palm-detective/oscilloscope-/README.md

# oscilloscope-
upgrade of Ds211 hardware and software all open source

update processor to stm32f4 processor
change display to 3.5 inch raspberry pi diplay using spi
change switches to touch screen
change ide from iar to stm cube
board to fit in raspberry pi 3B case
