palm-detective/oscilloscope-/easyeda/BOM_oscilliscope copy_2023-02-05.csv

ID | Name | Designator | Footprint | Quantity | Manufacturer Part | Manufacturer | Supplier | Supplier Part | Price
1 | 33uF | C1,C2 | CAP-SMD_L3.2-W1.6-RD | 2 | TC211A336M006Y | Sunlord | LCSC | C128344 | 0.02
2 | 1uF | C3,C16,C19,C22 | C0402 | 4 | CL05A105KP5NNNC | SAMSUNG | LCSC | C14445
3 | 4.7uF | C4,C5,C8,C10 | C0805 | 4 | CL21A475KAQNNNE | SAMSUNG | LCSC | C1779 | 0.002
4 | 7pF | C6,C7,C9 | C0402 | 3 | 0402CG7R0C500NT | FH | LCSC | C1577
5 | 33pF | C11,C24 | C0402 | 2 | 0402CG330J500NT | FH | LCSC | C1562
6 | 100nF | C12,C13,C14,C15,C17,C27,C28,C29 | C0402_NEW | 8 | CL05B104KO5NNNC | SAMSUNG | LCSC | C1525
7 | 10uF | C18,C20,C23 | C0402 | 3 | CL05A106MQ5NUNC | SAMSUNG | LCSC | C15525 | 0.001
8 | 10pF | C21 | C0603 | 1 | CL10C100JB8NNNC | SAMSUNG | LCSC | C1634 | 0.001
9 | 47pF | C25 | C0603 | 1 | CL10C470JB8NNNC | SAMSUNG | LCSC | C1671 | 0.001
10 | 510pF | C26 | C0603 | 1 | CL10B511KB8NNNC | SAMSUNG | LCSC | C170144 | 0.002
11 | SMBJ5.0CA | D1 | SMB_L4.6-W3.6-LS5.3-BI | 1 | SMBJ5.0CA | Brightking | LCSC | C78424 | 0.009
12 | LESD5Z5.0T1G | D2,D3,D4,D5 | SOD-523_L1.2-W0.8-LS1.6-RD | 4 | LESD5Z5.0T1G | LRC | LCSC | C136171 | 0.003
13 | Header-1x2 | H1 | HDR-TH_2P-P2.54-V-M-1 | 1 | 826629-2 | TE Connectivity | LCSC | C86471 | 0.067
14 | MTP125-1213S1 | H2 | HDR-TH_26P-P2.54-V-M-R2-C13-S2.54 | 1 | MTP125-1213S1 | MINTRON | LCSC | C358701 | 0.023
15 | 10Ω | L1,L2,L3,L4,L5,L6 | L0402 | 6 | BLM15AG100SN1D | MuRata | LCSC | C76882 | 0.001
16 | 100uH | L7,L8 | IND-SMD_L3.5-W3.0 | 2 | SCCD32-101KT | Yanchuang | LCSC | C532859 | 0.005
17 | 2kΩ | R4 | R0402 | 1 | 0402WGF2001TCE | UniOhm | LCSC | C4109
18 | 1M | R6 | R0603 | 1 | 0603WAF1004T5E | UniOhm | LCSC | C22935
19 | 1kΩ | R7,R8 | R0402 | 2 | 0402WGF1001TCE | UniOhm | LCSC | C11702
20 | 22 | R9,R15 | R0402 | 2 | RC0402FR-0722RL | YAGEO | LCSC | C114765
21 | 18kΩ | R10,R16 | R0402 | 2 | 0402WGF1802TCE | UniOhm | LCSC | C25762
22 | 75kΩ | R11,R12 | R0402 | 2 | 0402WGF7502TCE | UniOhm | LCSC | C25798
23 | 1.5M | R13 | R0603 | 1 | 0603WAF1504T5E | UniOhm | LCSC | C4172
24 | 330K | R14 | R0603 | 1 | RTT03334JTP | RALEC | LCSC | C103555
25 | DOSIN-801-0005 | RF1 | BNC-TH_DOSIN-801-0005 | 1 | DOSIN-801-0005 | dosinconn | LCSC | C521213 | 0.286
26 | 3.3kΩ | RN1 | RES-ARRAY-SMD_0603-8P-L3.2-W1.6-BL | 1 | 4D03WGJ0332T5E | UNI-ROYAL(厚声) | LCSC | C12013 | 0.001
27 | 74HC4053PW | U1 | TSSOP-16_L5.0-W4.4-P0.65-LS6.4-BL | 1 | 74HC4053PW | PHILIPS | LCSC | C5648 | 0.046
28 | TSH82IDT | U2 | SO-8_L4.9-W3.9-P1.27-LS5.9-BL | 1 | TSH82IDT | STMicroelectronics | LCSC | C221510 | 0.194
29 | MAX1720EUTG | U3 | TSOP-6_L3.0-W1.5-P0.95-LS2.8-BR | 1 | MAX1720EUTG | ON Semicon | LCSC | C70466 | 0.076
30 | STM32F446RCT6 | U4 | LQFP-64_L10.0-W10.0-P0.50-LS12.0-BL | 1 | STM32F446RET6 | STMicroelectronics | LCSC | C69336 | 1.037
31 | AMS1117-3.3 | U5 | SOT-223_L6.5-W3.5-P2.30-LS7.0-BR | 1 | AMS1117-3.3 | SK | LCSC | C165482 | 0.012
32 | W25Q64JVSSIQ | U6 | SOP-8_L5.3-W5.3-P1.27-LS8.0-BL | 1 | W25Q64JVSSIQ | WINBOND | LCSC | C83140 | 0.071
33 | MICRO-02 | USB1 | MICRO-USB-SMD_MICRO-02-GXPX-A1T2 | 1 | MICRO-02-G1P3-A1T2 | Yuandi(台湾元迪) | LCSC | C2682518 | 0.011
34 | 25MHz | X1 | OSC-SMD_4P-L3.2-W2.5-BL | 1 | X322525MOB4SI | YXC | LCSC | C9006 | 0.014
