palm-detective/oscilloscope-/todo.txt

08/22/2021  add touch buttons DONE
            fix routing on pcb DONE
            use 0402 components rather than 0603 DONE

09/11/2021  finish simulation
            software test

future	    use rspberry pi 4 format -- usb c
	    add pulseview interface
            add sd card
