palm-detective/oscilloscope-/easyeda/Schematic_oscilliscope copy_2022-06-30.pdf

# S2 10 S1 11 1Y0 12 1Y1 13 1Z 14 2Z 15 VCC 16

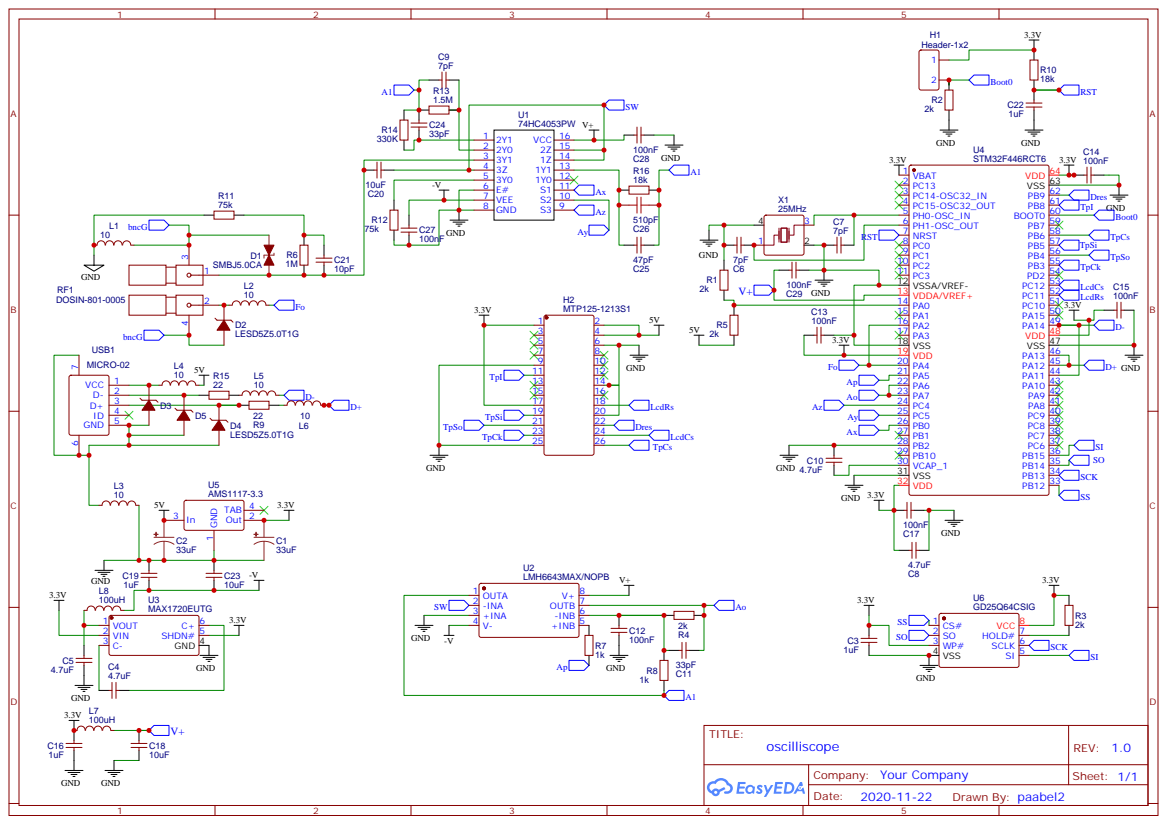
[picture p10: page 1]
