palm-detective/oscilloscope-/ltspicemodel/Schematic_Simulation_2021-08-07.pdf

# S2 10 S1 11 1Y0 12 1Y1 13 1Z 14 2Z 15 VCC 16

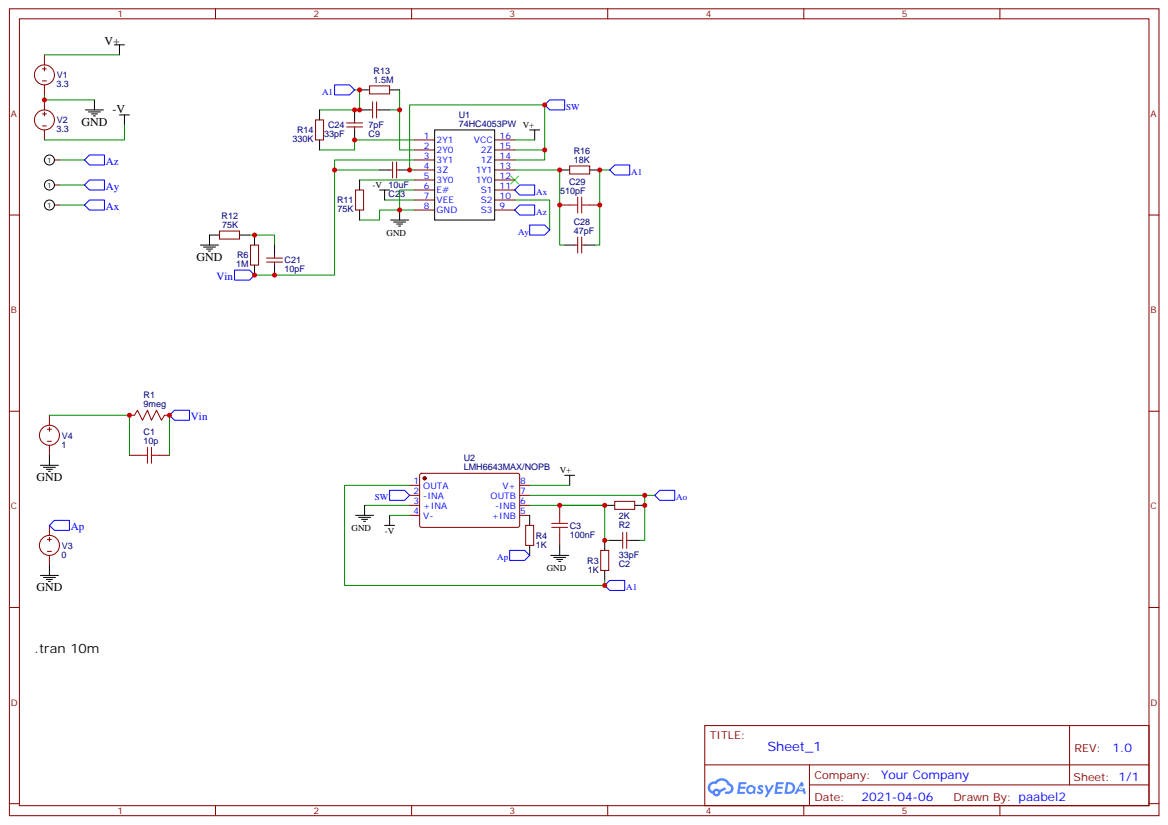
[picture p12: page 1]
