palm-detective/oscilloscope-/easyeda/Schematic_oscilliscope copy_2021-07-18.pdf

# S2 10 S1 11 1Y0 12 1Y1 13 1Z 14 2Z 15 VCC 16

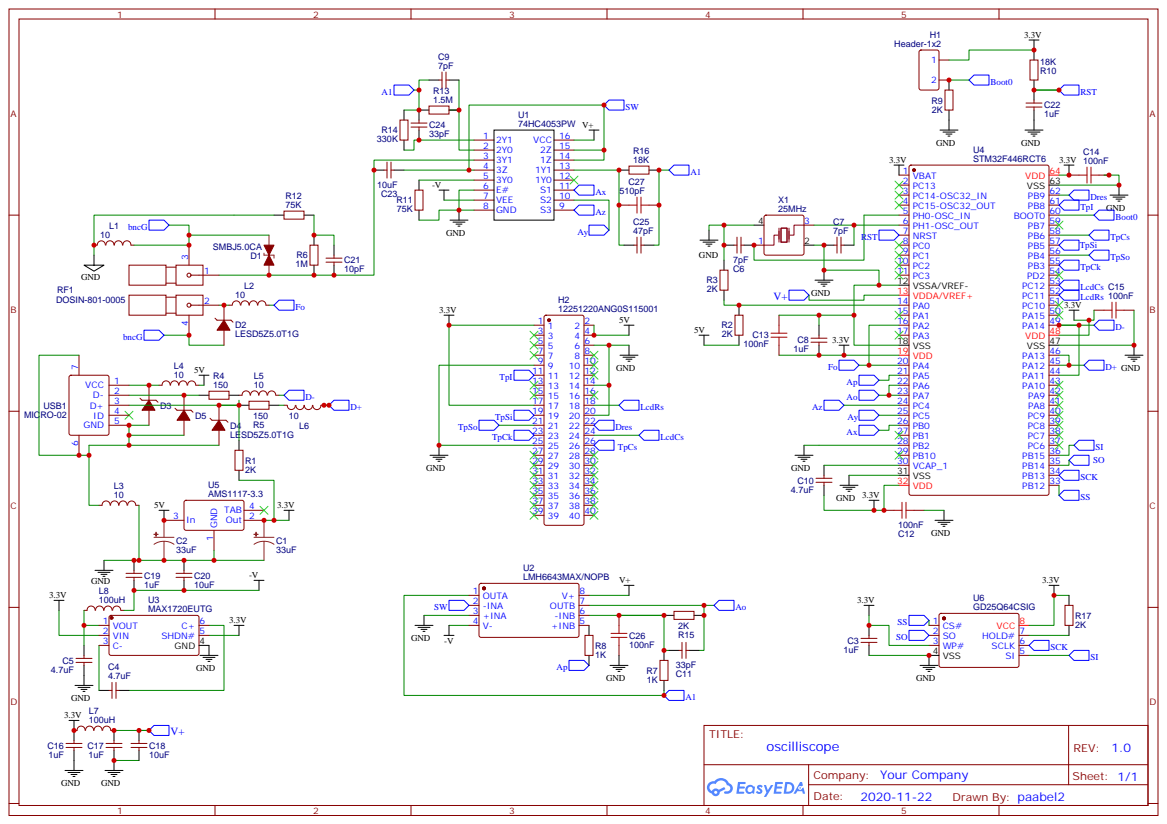
[picture p13: page 1]
