palm-detective/oscilloscope-/easyeda/PCB_NEW_PCB_2023-02-05.pdf

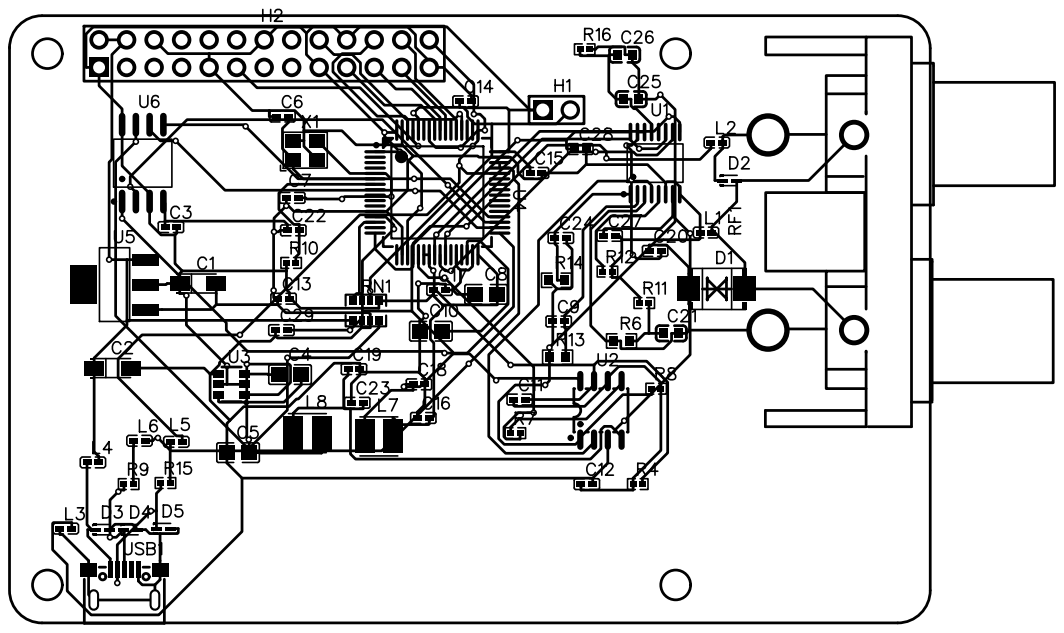
[picture p14: page 1]
