palm-detective/oscilloscope-/ltspicemodel/sim1224.pdf

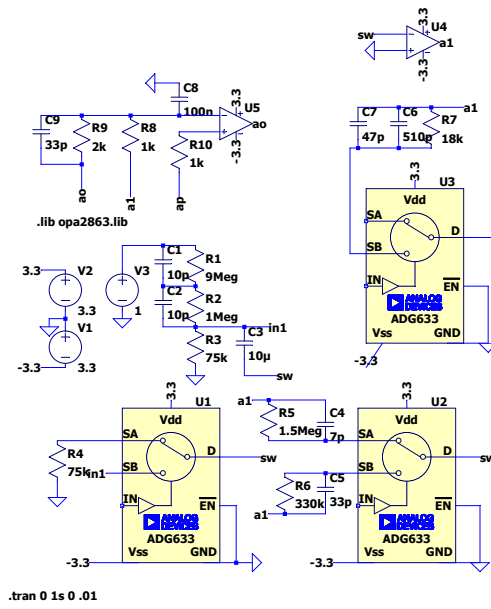
[picture p15: page 1]
