palm-detective/oscilloscope-/ltspicemodel/sin1221.pdf

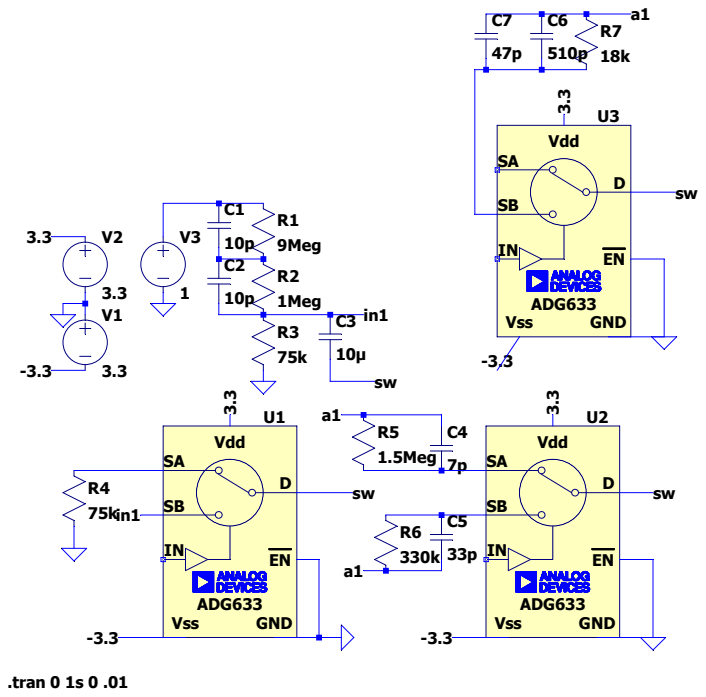
[picture p16: page 1]
