palm-detective/oscilloscope-/easyeda/PCB_NEW_PCB_2022-08-28.pdf

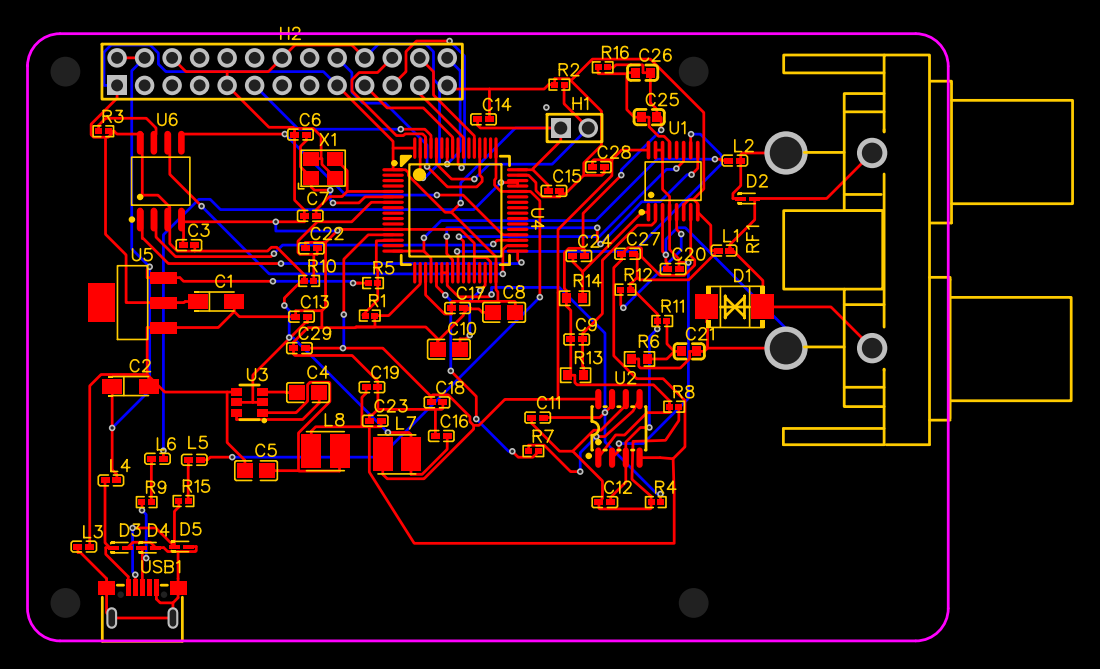
[picture p17: page 1]
