palm-detective/oscilloscope-/easyeda/PCB_NEW_PCB_2022-07-08.pdf

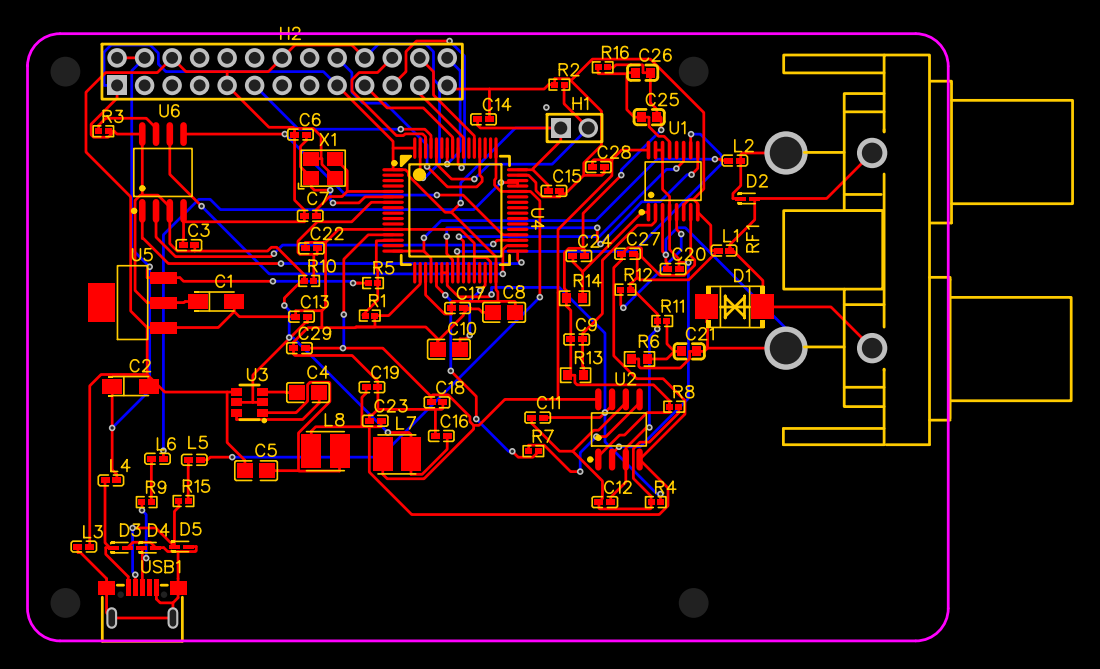
[picture p18: page 1]
