palm-detective/oscilloscope-/easyeda/PCB_NEW_PCB_2022-07-03.pdf

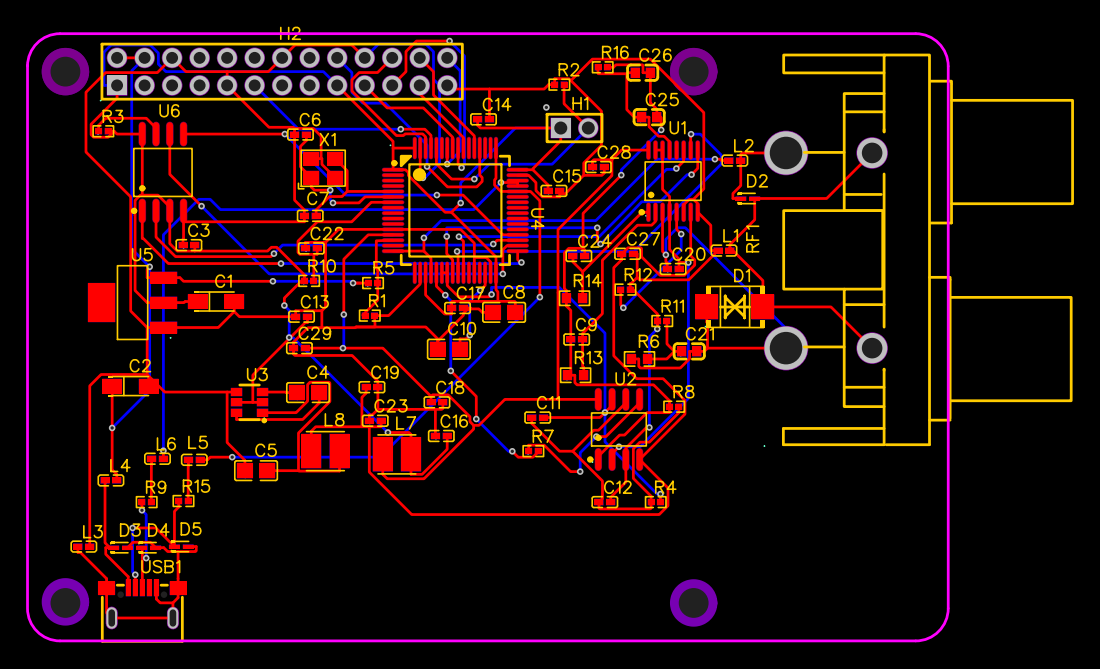
[picture p19: page 1]
