palm-detective/oscilloscope-/ltspicemodel/sim.asc

C1: cap; 10p
C2: cap; 10p
C3: cap; 10µ
C4: cap; 7p
C5: cap; 33p
C6: cap; 510p
C7: cap; 47p
C8: cap; 100n
C9: cap; 33p
R1: res; 9Meg
R2: res; 1Meg
R3: res; 75k
R4: res; 75k
R5: res; 1.5Meg
R6: res; 330k
R7: res; 18k
R8: res; 1k
R9: res; 2k
R10: res; 1k
U1: ADG633
U2: ADG633
U3: ADG633
U4: OPA2683
U5: OPA2683
V1: voltage; 3.3
V2: voltage; 3.3
V3: voltage; SINE(0 1 1k)
Named nets: 0, 3.3, -3.3, in1, sw, a1, ao, ap
.lib opa2863.lib
.tran 0 0.1s 0 0.001
