palm-detective/oscilloscope-/(list of files, drawings)

Other design files:
easyeda/Autorouter_NEW_PCB_2021-09-06.dsn
easyeda/PCB_NEW_PCB_2021-08-04.json
easyeda/PCB_NEW_PCB_2021-09-06.json
easyeda/PCB_NEW_PCB_2021-09-11.json
easyeda/SCH_oscilliscope copy_2021-08-04.json
easyeda/SCH_oscilliscope copy_2021-09-11.json
