palm-detective/oscilloscope-/oscilliscope/Core/Src/main.c

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
/* Includes ------------------------------------------------------------------*/
#include "main.h"
#include "fatfs.h"
#include "usb_device.h"

/* USER CODE BEGIN Includes */
#include "Lcd_ctl.h"
#include "Touch_ctl.h"
#include "Flash.h"
#include "Draw.h"
#include "Process.h"
#include "File.h"
#include "Menu.h"
#include "Display.h"
#include "Bios.h"
#include "Flash.h"
/* USER CODE END Includes */

ADC_HandleTypeDef hadc1;
ADC_HandleTypeDef hadc2;
DMA_HandleTypeDef hdma_adc1;

DAC_HandleTypeDef hdac;
DMA_HandleTypeDef hdma_dac1;

SPI_HandleTypeDef hspi2;
SPI_HandleTypeDef hspi3;

TIM_HandleTypeDef htim1;
TIM_HandleTypeDef htim3;
TIM_HandleTypeDef htim5;
TIM_HandleTypeDef htim7;

/* USER CODE BEGIN PV */
TIM_OC_InitTypeDef octim1;
TIM_OC_InitTypeDef octim3;
TIM_OC_InitTypeDef octim5;
char  APP_VERSION[] = "V2.00";   //bump version to 2
/* USER CODE END PV */

void SystemClock_Config(void);
static void MX_GPIO_Init(void);
static void MX_DMA_Init(void);
static void MX_ADC1_Init(void);
static void MX_ADC2_Init(void);
static void MX_DAC_Init(void);
static void MX_SPI2_Init(void);
static void MX_SPI3_Init(void);
static void MX_TIM1_Init(void);
static void MX_TIM3_Init(void);
static void MX_TIM5_Init(void);
static void MX_TIM7_Init(void);
/**
  * @brief  The application entry point.
  * @retval int
  */
int main(void)
{
  /* USER CODE BEGIN 1 */
  short i;
  char SAVE_FLAG = 0;
  char Pop_Num = 0;
  unsigned dma_tmp;
  /* USER CODE END 1 */

  /* MCU Configuration--------------------------------------------------------*/

  /* Reset of all peripherals, Initializes the Flash interface and the Systick. */
  HAL_Init();

  /* Configure the system clock */
  SystemClock_Config();

  /* Initialize all configured peripherals */
  MX_GPIO_Init();
  MX_DMA_Init();
  MX_ADC1_Init();
  MX_ADC2_Init();
  MX_DAC_Init();
  MX_SPI2_Init();
  MX_SPI3_Init();
  MX_TIM1_Init();
  MX_TIM3_Init();
  MX_TIM5_Init();
  MX_USB_DEVICE_Init();
  MX_TIM7_Init();
  MX_FATFS_Init();
  /* USER CODE BEGIN 2 */

  // initialize adc dma
  __HAL_DMA_DISABLE(&hdma_adc1);
  dma_tmp = hdma_adc1.Instance->CR;
  dma_tmp &= 0x0FFCFFFE;
  dma_tmp |= 0x30000; //set very high pirority
  hdma_adc1.Instance->CR = dma_tmp;

   hdma_adc1.Instance->M0AR = (unsigned)&Sampl[2];
   hdma_adc1.Instance->PAR = hadc1.Instance->DR;
   __HAL_DMA_SET_COUNTER(&hdma_adc1, 0x1000);
   __HAL_DMA_ENABLE(&hdma_adc1);

  // inittialize LCD and touch screen
  Init_LCD();
  Init_Touch();

  SetColor(BLK, WHT);

  DispStr8x14(8, 90, PRN, "         Oscilloscope              ");
  DispStr8x14(8+22*8, 90, PRN, APP_VERSION);
  DispStr8x14(8, 70, PRN, "        System Initializing...       ");

  HAL_Delay(1000);

//=============================check callibration׼===========================
  Read_CalFlag();

  if(Cal_Flag == 1)
  {
	  Cal_Flag = 0;
	  SetColor(BLK, WHT);
	  Zero_Align();                              //set zero
	  Restore();                                 //restore list
	  Save_Parameter();                          //save list
	  Save_Kpg();
  }
  Read_Kpg();
  Read_Parameter();
  File_Num();
  memcpy(Data, DEMO, 310);

  LCD_ClrScrn(GRY);
  Update_Title();

  List[SMPL_DPTH].Flg |= UPD;

  StdBy_Time = List[STANDBY].Val * MIN_UNIT;

  // Start timer
  HAL_TIM_Base_Start_IT(&htim3);

  /* USER CODE END 2 */

  /* Infinite loop */
  /* USER CODE BEGIN WHILE */
  while (1)
  {
	    if((List[STANDBY].Val != 0)&&(StdBy_Time == 0))
	    {
	      StdBy_Flag = 1;
	    }

	    Update_Detail();
	    Update_Blink();
	    WaveProcess();
	    DrawWindow(WaveBuf, ParamTab);

	   if(TIM_BASE_Val!=0)
	    {
	      List[TIM_BASE].Val=TIM_BASE_Val;
	      List[TIM_BASE].Flg |= UPD;
	      TIM_BASE_Val=Current;
	      Update_Title();
	      Current=TIM_BASE_Val;
	      TIM_BASE_Val=0;
	    }
    /* USER CODE END WHILE */

    /* USER CODE BEGIN 3 */
	    if(Key_Buffer != 0)
	    {
	      StdBy_Flag = 0;
	      PopupCnt = 10;
	      List[MenuNow[Current]].Flg |= UPD;

	      switch (Key_Buffer)
	      {
	     case KEYCODE_MEM:
	         i = Save_Bmp(List[SAVE_BMP].Val);
	         DispFileInfo(i);
	         DispBMPInfo();
	        break;

	     case KEYCODE_ACT:
	       SAVE_FLAG=0;
	       if(PopType & DAILOG_POP) Close_Pop();
	       else {
	         Dialog_Pop("Save All ParamTab?");
	         Pop_Num = 1;
	       }
	       break;

	     case KEYCODE_PLAY:
	       if((Current == ST)&&(Cal_Flag==0))
	       {
	         if(PopType & DAILOG_POP){
	           if(Pop_Num == 1){
	             Save_Parameter();
	             Close_Pop();
	           }
	           else{
	             Close_Pop();
	             List_Pop();
	           }
	         }
	         else if((PopType & LIST_POP) && (MenuNow[ST]==RESTORE )) {
	           Restore_CalPar();
	           Dialog_Pop("Save All ParamTab?");
	           Cal_Flag = 1;
	         }
	         else if((PopType & LIST_POP) && (MenuNow[ST]==AUTO_CAL )) {
	           Close_Pop();
	           Calibrate_Pop("Waiting for Calibration...");
	           Cal_Flag = 1;
	           DrawWindow(WaveBuf, ParamTab);
	           Zero_Align();
	           Update_Proc_All();
	           Close_Pop();
	           CalSave_Pop("Save Cal ParamTab?");
	         }
	         break;
	       }
	       else if((Current == ST)&&(Cal_Flag==1)){
	         if(PopType & DAILOG_POP){
	           Save_Kpg();
	           Close_Pop();
	           Cal_Flag = 0;
	         }
	         break;
	       }

	       if ((Current == FN)&&(PopType & LIST_POP)){
	         i = 0;
	         {
	           if(SAVE_FLAG==KEYCODE_MEM)Close_Pop();
	           if(MenuNow[FN] == SAVE_BMP) i = Save_Bmp(List[SAVE_BMP].Val);
	           if(MenuNow[FN] == SAVE_DAT) i = Save_Dat(List[SAVE_DAT].Val);
	           if(MenuNow[FN] == SAVE_BUF) i = Save_Buf(List[SAVE_BUF].Val);
	           if(MenuNow[FN] == SAVE_CSV) i = Save_Csv(List[SAVE_CSV].Val);
	           if(MenuNow[FN] == SAVE_SVG) i = Save_Svg(List[SAVE_SVG].Val);
	           if(MenuNow[FN] == LOAD_DAT) i = Load_Dat(List[LOAD_DAT].Val);
	           if(MenuNow[FN] == LOAD_BUF) i = Load_Buf(List[LOAD_BUF].Val);
	           SAVE_FLAG = 0;
	         }
	         DispFileInfo(i);

	         if(PopType & DAILOG_POP)  Close_Pop();

	       }
	       else if((PopType & DAILOG_POP ) &&(SAVE_FLAG!=KEYCODE_MEM)){
	         Save_Parameter();
	         Cal_Flag = 0;
	         Close_Pop();
	         break;
	       }
	       else {
	          if(Status & STOP){
	            if(Status & LOADM )Status &= ~LOADM;
	            Status &= ~STOP;
	            if(List[SYNCMODE].Val==SINGL) ADC_Start();
	            if(List[SYNCMODE].Val==NORM)  ADC_Start();
	            Norm_Clr = 1;
	            SNGL_Kflag = 1;
	            Update_Proc_All();

	            if(*(short*)F_Sector==0xaa55)Restore_Scene();

	          }
	          else {
	            Status |=  STOP;
	            Ch1_Posi = List[V0_POSI].Val;
	            Ch2_Posi = List[EXT_POSI].Val;
	            Tri_Posi = List[THRESHOLD].Val;
	          #ifdef SAVEBMP
	            Save_Bmp(List[SAVE_BMP].Val);
	            List[SAVE_BMP].Val++;
	          #endif
	          }
	        }
	        DispStatus();
 	       break;

	      case KEYCODE_D_MANU:
	        if(List[FITTRIGG].Val)
	        {
	          Auto_Fit();
	        }
	        break;

	      case KEYCODE_MANU:
	        if(!(PopType & LIST_POP)){
	            if(Cal_Flag){
	              Cal_Flag = 0;
	              Close_Pop();
	            }else{
	              Cal_Flag = 0;
	              List_Pop();
	            }
	        }
	        else {
	          Close_Pop();

	          if(Current == XN)      List[T1_POSI   ].Flg |= UPD;
	          else if(Current == YN) List[V1_POSI   ].Flg |= UPD;
	          else                   List[MenuNow[SN]].Flg |= UPD;

	          if(MenuNow[Current] == SMPL_DPTH) List[SMPL_DPTH].Flg  |= UPD;
	          else if(Current == FN)           List[MenuNow[FN]].Flg |= UPD;
	          else                             List[MenuNow[ME]].Flg |= UPD;
	        }
	        break;

	      case KEYCODE_UP:
	        if (PopType & LIST_POP){
	          if(MenuNow[Current] > MU_BEGN[Current]) MenuNow[Current]--;
	          else                  MenuNow[Current] += M_ITEMS[Current]-1;
	        } else {
	          if (Current > 0) Current--;
	          else             Current = ST;
	        }
	        break;

	     case KEYCODE_DOWN:
	        if(PopType & LIST_POP){
	          MenuNow[Current]++;
	          if(MenuNow[Current] >=(MU_BEGN[Current]+M_ITEMS[Current])){
	            MenuNow[Current] = MU_BEGN[Current];
	          }
	        } else {
	          if (Current < 7) Current++;
	          else             Current = YN;
	        }
	        break;

	      case KEYCODE_LEFT:
	        if((Current==ST)&& !(PopType & LIST_POP))break;
	        List[MenuNow[Current]].Flg |= UPD;
	        if(List[MenuNow[Current]].Val <=MIN[MenuNow[Current]]){
	          if((MenuNow[Current] == COUPLING)||(MenuNow[Current] == YN_TYPE )||
	            (MenuNow[Current] == XN_TYPE )||(MenuNow[Current] == EXT_HIDE)||
	            ( MenuNow[Current] == FITTRIGG)||(MenuNow[Current] == TR_MODE )||
	            ( MenuNow[Current] == SYNCMODE)||(MenuNow[Current] == EXT_REFN)||
	            (MenuNow[Current] == PROBEATT)||(MenuNow[Current] == TPYE_OUT))
	            List[MenuNow[Current]].Val =MAX[MenuNow[Current]] ;
	        } else {
	          if((MenuNow[Current] == VIEWPOSI)&&((List[MenuNow[Current]].Val) >=150 ))
	            List[MenuNow[Current]].Val-=25;
	          else{

	            if(MenuNow[Current] == THRESHOLD){
	              if((List[V0_POSI].Val + List[THRESHOLD].Val) > 2)
	                List[MenuNow[Current]].Val--;
	            }
	            else if(MenuNow[Current] == V0_POSI){
	              if((List[V0_POSI].Val + List[THRESHOLD].Val) <2){
	                List[V0_POSI].Val--;
	                List[THRESHOLD].Val++;
	              }else List[MenuNow[Current]].Val--;
	            }
	            else if((MenuNow[Current] ==V1_POSI) && (List[V1_POSI].Val <= List[V2_POSI].Val))
	            List[MenuNow[Current]].Val=List[V2_POSI].Val;
	            else List[MenuNow[Current]].Val--;
	          }
	          //==============================================
	            if(MenuNow[Current] == SMPL_DPTH){
	              List[VIEWPOSI].Val=1 ;
	           }
	            if((MenuNow[Current] ==T2_POSI) && (List[T2_POSI].Val <= List[T1_POSI].Val))
	              List[MenuNow[Current]].Val=List[T1_POSI].Val;
	        }
	        if(Current == TRG) Status &= ~STOP;
	        break;

	      case KEYCODE_RIGHT:
	        if((Current==ST)&& !(PopType & LIST_POP))break;
	        List[MenuNow[Current]].Flg |= UPD;
	        if(List[MenuNow[Current]].Val >=MAX[MenuNow[Current]] ){
	          if((MenuNow[Current] == COUPLING)||(MenuNow[Current] == YN_TYPE )||
	            (MenuNow[Current] == XN_TYPE )||(MenuNow[Current] == EXT_HIDE)||
	            ( MenuNow[Current] == FITTRIGG)||(MenuNow[Current] == TR_MODE )||
	            ( MenuNow[Current] == SYNCMODE)||(MenuNow[Current] == EXT_REFN)||
	            (MenuNow[Current] == PROBEATT)||(MenuNow[Current] == TPYE_OUT))
	            List[MenuNow[Current]].Val =MIN[MenuNow[Current]] ;
	        } else {
	            if(MenuNow[Current] == VIEWPOSI)
	            {
	              if(List[MenuNow[Current]].Val <(DEPTH[List[SMPL_DPTH].Val]-(350-List[SMPL_DPTH].Val)))
	              {
	                if(List[MenuNow[Current]].Val >150 )
	                  List[MenuNow[Current]].Val += 25;
	                else
	                  List[MenuNow[Current]].Val++;
	              }
	            }
	            else{

	              if(MenuNow[Current] == THRESHOLD){
	                if((List[V0_POSI].Val + List[THRESHOLD].Val) < 198)
	                 List[MenuNow[Current]].Val++;
	              }
	              else if(MenuNow[Current] == V0_POSI){
	                if((List[V0_POSI].Val + List[THRESHOLD].Val) > 198){
	                  List[V0_POSI].Val++;
	                  List[THRESHOLD].Val--;
	                }else List[MenuNow[Current]].Val++;
	              }
	              else if((MenuNow[Current] ==V2_POSI) && (List[V2_POSI].Val >= List[V1_POSI].Val))
	                List[MenuNow[Current]].Val=List[V1_POSI].Val;
	              else List[MenuNow[Current]].Val++;
	            }
	            //==============================================
	            if((MenuNow[Current] ==T1_POSI) && (List[T1_POSI].Val >= List[T2_POSI].Val))
	               List[MenuNow[Current]].Val=List[T2_POSI].Val;
	        }
	        if(Current == TRG) {Status &= ~STOP;
	        if(List[SYNCMODE].Val==SINGL)ADC_Start(); }
	        break;

	     } //switch end
	     List[MenuNow[Current]].Flg |= UPD;
	     StdBy_Time  = List[STANDBY].Val * MIN_UNIT;

	      if(PopType & LIST_POP) Show_List();
	      Update_Title();
	      Key_Buffer = 0;
	    } //if key end
  }
  /* USER CODE END 3 */
}

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
/* USER CODE BEGIN 4 */
// Callback: timer has rolled over
void HAL_TIM_PeriodElapsedCallback(TIM_HandleTypeDef *htim)
{
  // Check which version of the timer triggered this callback
  if (htim == &htim3 )
  {
	  htim->Instance->SR =0;
	  Tim3_ISP();
  }
}

/* USER CODE END 4 */
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
