palm-detective/oscilloscope-/oscilliscope/Core/Inc/main.h

#define Fo2_Pin GPIO_PIN_2
#define Fo2_GPIO_Port GPIOA
#define Fo4_Pin GPIO_PIN_4
#define Fo4_GPIO_Port GPIOA
#define Ap_Pin GPIO_PIN_5
#define Ap_GPIO_Port GPIOA
#define Ao_Pin GPIO_PIN_6
#define Ao_GPIO_Port GPIOA
#define AoA7_Pin GPIO_PIN_7
#define AoA7_GPIO_Port GPIOA
#define Az_Pin GPIO_PIN_4
#define Az_GPIO_Port GPIOC
#define Ay_Pin GPIO_PIN_5
#define Ay_GPIO_Port GPIOC
#define Ax_Pin GPIO_PIN_0
#define Ax_GPIO_Port GPIOB
#define Boot1_Pin GPIO_PIN_2
#define Boot1_GPIO_Port GPIOB
#define SS_Pin GPIO_PIN_12
#define SS_GPIO_Port GPIOB
#define SCK_Pin GPIO_PIN_13
#define SCK_GPIO_Port GPIOB
#define So_Pin GPIO_PIN_14
#define So_GPIO_Port GPIOB
#define Si_Pin GPIO_PIN_15
#define Si_GPIO_Port GPIOB
#define D__Pin GPIO_PIN_11
#define D__GPIO_Port GPIOA
#define D_A12_Pin GPIO_PIN_12
#define D_A12_GPIO_Port GPIOA
#define LcdRs_Pin GPIO_PIN_11
#define LcdRs_GPIO_Port GPIOC
#define LcdCs_Pin GPIO_PIN_12
#define LcdCs_GPIO_Port GPIOC
#define TpCk_Pin GPIO_PIN_3
#define TpCk_GPIO_Port GPIOB
#define TpSo_Pin GPIO_PIN_4
#define TpSo_GPIO_Port GPIOB
#define TpSi_Pin GPIO_PIN_5
#define TpSi_GPIO_Port GPIOB
#define TpCs_Pin GPIO_PIN_6
#define TpCs_GPIO_Port GPIOB
#define TpI_Pin GPIO_PIN_8
#define TpI_GPIO_Port GPIOB
#define Dres_Pin GPIO_PIN_9
#define Dres_GPIO_Port GPIOB
