palm-detective/oscilloscope-/oscilliscope/Core/Inc/Display.h

/*
 * Display.h
 *
 *  Created on: Jul 9, 2021
 *      Author: paul_
 */

#ifndef INC_DISPLAY_H_
#define INC_DISPLAY_H_

//==============================================================================
//                        System function
//==============================================================================
void DrawWindow(char* pBuf, short* pTab);


#endif /* INC_DISPLAY_H_ */
