palm-detective/oscilloscope-/(commit log)

2021-08-05 update to add working files
    added working schematic PCB , dimulation and code files
    [BOM_oscilliscope copy_2021-07-18.csv, BOM_oscilliscope copy_2021-07-29.csv, BOM_oscilliscope copy_2021-08-04.csv, PCB_NEW_PCB_2021-08-04.json, SCH_oscilliscope copy_2021-08-04.json]
2021-08-08 stm32 code
    stm32 code for project
2021-08-15 change to cubemx version
    changed to latest cubemx version
    changed TpI to input from interrupt
2021-08-19 dma changes
    added dma support
2021-08-20 dma
    more dma work
2021-08-22 dma setup
    finished dma setup
2021-08-26 button layout
    initial button layout
2021-09-05 pcb changes
    pcb routed header changed to 26 pin
    [BOM_oscilliscope copy_2021-07-18.csv, BOM_oscilliscope copy_2021-07-29.csv, BOM_oscilliscope copy_2021-09-05.csv]
2021-09-07 new BOM. more touch stuff
    new BOM and board layout
    more touch code
    [BOM_oscilliscope copy_2021-09-05.csv]
2021-09-11 changed todo
    revised todo
    added easyeda files
    [PCB_NEW_PCB_2021-09-11.json, SCH_oscilliscope copy_2021-09-11.json]
2021-10-11 fixed include
    fixed double include
    [main.c]
2021-11-08 spi changes
    changed spi and stack
2021-11-30 updated files
    updated easy eda files
    [Autorouter_NEW_PCB_2021-09-06.dsn, BOM_oscilliscope copy_2021-08-04.csv, BOM_oscilliscope copy_2021-09-06.csv, PCB_NEW_PCB_2021-08-04.json, PCB_NEW_PCB_2021-09-06.json, SCH_oscilliscope copy_2021-08-04.json]
2022-01-31 component update
    updated components
    revised numbering
    [BOM_oscilliscope copy_2021-09-05.csv, BOM_oscilliscope copy_2022-01-31.csv, PCB_NEW_PCB_2021-09-06.json]
2022-05-13 pcb canges json delete
    updated pcb components and routes removed json files
    [Autorouter_NEW_PCB_2021-09-06.dsn, BOM_oscilliscope copy_2022-01-31.csv, BOM_oscilliscope copy_2022-05-09.csv, PCB_NEW_PCB_2021-09-11.json, PickAndPlace_NEW_PCB_2022-05-13.csv, SCH_oscilliscope copy_2021-09-11.json]
2022-05-24 added file changes
    added latest schematics and BOM
    added scope fat configuration
    [BOM_oscilliscope copy_2022-05-23.csv]
2022-06-07 component update
    revised to latest componets
    [BOM_oscilliscope copy_2021-09-06.csv, BOM_oscilliscope copy_2022-05-09.csv, BOM_oscilliscope copy_2022-06-02.csv, PickAndPlace_NEW_PCB_2022-06-06.csv]
2022-06-29 removed old version
    removed old version
    [PickAndPlace_NEW_PCB_2022-05-13.csv]
2022-06-29 version clean up
    [BOM_oscilliscope copy_2022-05-23.csv]
2022-06-29 fixed vcap error
    fixed Vcap error
    added processor decoupling
    [BOM_oscilliscope copy_2022-06-28 .csv, PickAndPlace_NEW_PCB_2022-06-29.csv]
2022-07-01 Analog bypass fixes
    fixed analog bypass on processor
    [BOM_oscilliscope copy_2022-06-30 .csv]
2022-07-03 PCB changes
    reroute pcb to go along with analog bypass changes
    [PickAndPlace_NEW_PCB_2022-07-03.csv]
2022-07-09 fixed Si &So
    had SI and So swapped to memory
    [PickAndPlace_NEW_PCB_2022-07-08.csv]
2022-07-10 updated to latest tool chain
    updated to latest MX and IDE
2022-08-30 revised componets
    changed opamp to ths82
    deleted old files
    [BOM_oscilliscope copy_2022-06-02.csv, BOM_oscilliscope copy_2022-06-28 .csv, BOM_oscilliscope copy_2022-08-23.csv, BOM_oscilliscope copy_2022-08-28.csv, PickAndPlace_NEW_PCB_2022-06-06.csv, PickAndPlace_NEW_PCB_2022-07-03.csv, PickAndPlace_NEW_PCB_2022-08-29.csv]
2022-12-22 revised touch
    missed in last commit
    [Bios.c]
2022-12-22 added new model
    added model based on schematic
2023-02-05 revised sechmatic
    finished and rearranged schematic
2023-02-05 revised to use resistor network
    changed resistors to network
    from 2k to 3.3k
    [BOM_oscilliscope copy_2023-02-05.csv, PickAndPlace_NEW_PCB_2023-02-05.csv]
2023-02-05 tool chain upgrade
    updated stm32 ide
