palm-detective/oscilloscope-/(notices)

Notices in the files:
oscilliscope/Core/Src/main.c:
© Copyright (c) 2021 STMicroelectronics.
All rights reserved.
This software component is licensed by ST under Ultimate Liberty license
